sdedonatis/meeting-status-light/stl/top.stl

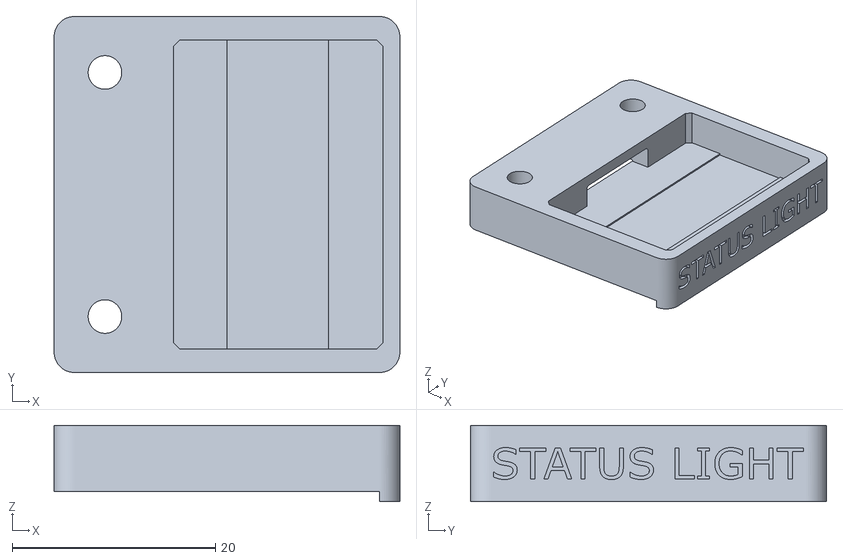
[picture p3: CAD file, 2024-10-08]
stl/top.stl
34.0 x 35.0 x 7.50
