sdedonatis/meeting-status-light/stl/indicator.stl

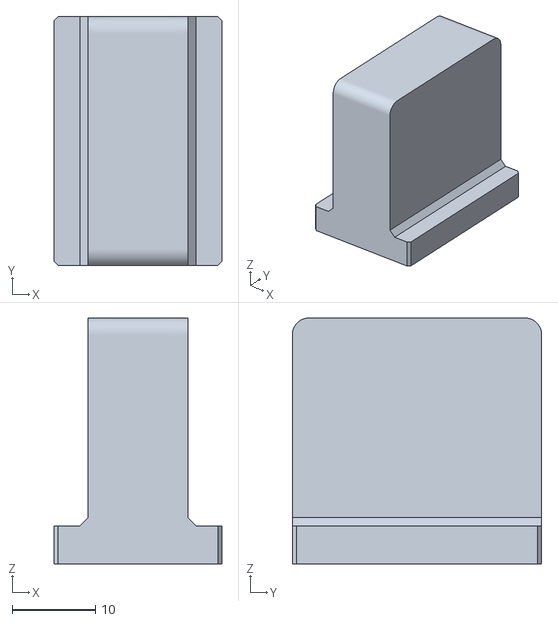
[picture p4: CAD file, 2024-10-08]
stl/indicator.stl
20.2 x 30.0 x 29.6
