sdedonatis/meeting-status-light/stl/bottom.stl

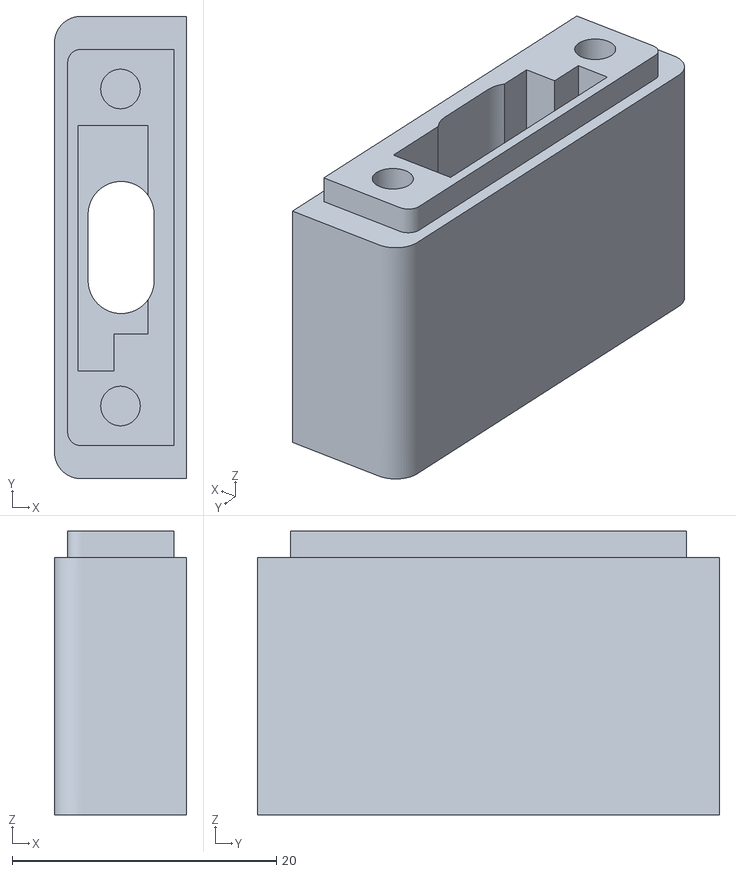
[picture p5: CAD file, 2024-10-08]
stl/bottom.stl
10.0 x 35.0 x 21.5
