sdedonatis/meeting-status-light/(commit log)

2024-10-08 Initial models upload
    [bottom.stl, indicator.stl, top.stl]
2024-11-14 Turn off leds after 15 seconds of not receiving data
